open-flight/openflight-enclosure/stls/camera/eol/Front-Camera-Sound-Detector.stl

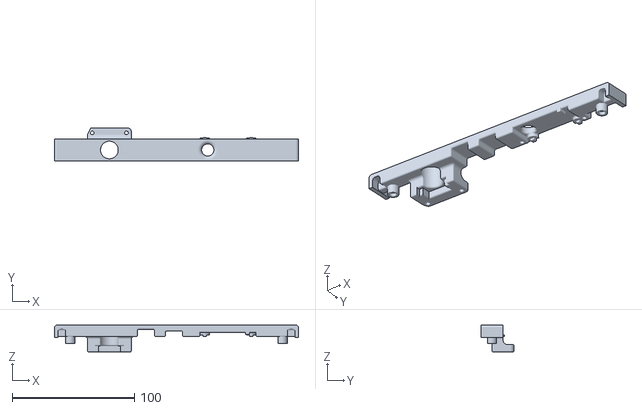
[picture p1: CAD file, 2026-11-04]
stls/camera/eol/Front-Camera-Sound-Detector.stl
200.0 x 27.0 x 22.0
