open-flight/openflight-enclosure/(list of files, cad)

Other CAD files:
stls/camera/v1/Front-Camera-Sound-Detector.stl
